Numax-cz/NapicuFridge/schematic/Fridge.sch

## EAGLE design schematic/Fridge.sch (2024-03-31)

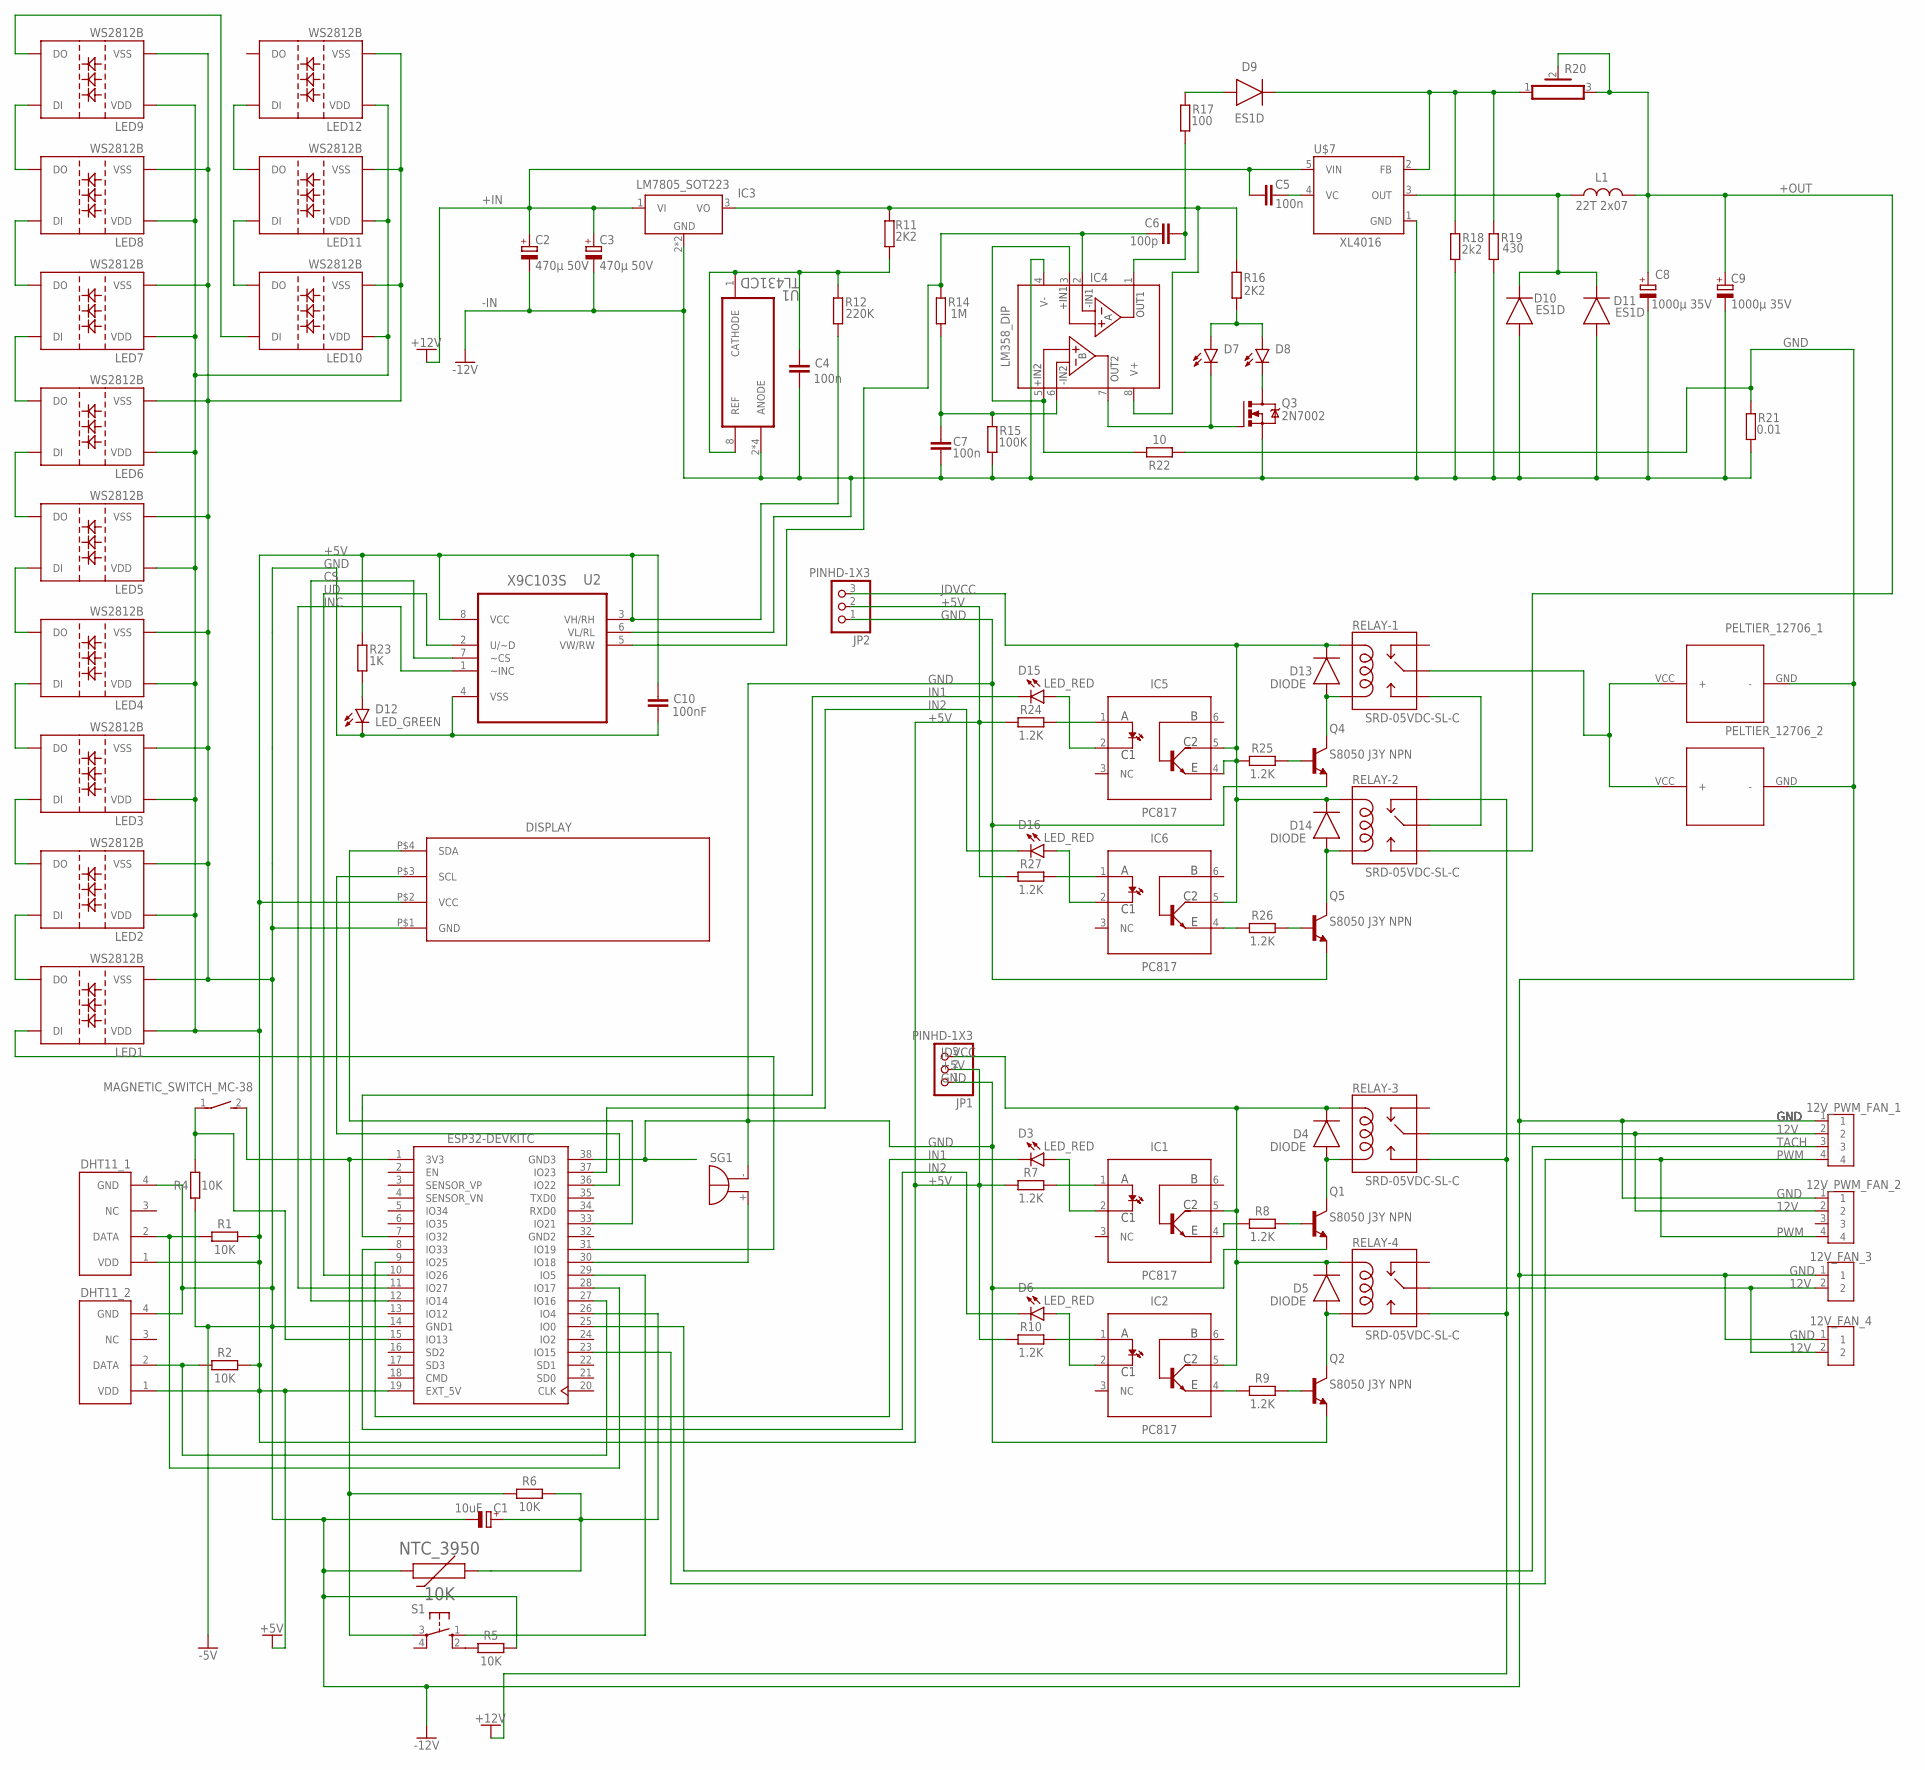
[picture p2: schematic Fridge.sch]

Parts:
12V_FAN_3, 12V_FAN_4: B2P-VH; B2P-VH_396-2N
12V_PWM_FAN_1: 12V_FAN1; B4B-XH-A
12V_PWM_FAN_2: B4B-XH-A
C1: 10uF; CAPPRD508W65D1000H1100B
C2, C3: 470µ 50V; CAPPRD550W60D1200H2000B
C4, C5, C7: 100n; CAPRD2261W240D5080H5555B
C6: 100p; CAPRD2261W240D5080H5555B
C8, C9: 1000µ 35V; CAPPRD550W60D1200H2000B
C10: 100nF; CAPC1005X60
D3, D6, D8, D15, D16: LED_RED; LEDC1005X25N_FLAT-R
D4, D5, D13, D14: DIODE; DIOMELF5024
D7: LED_BLUE; LEDC1005X25N_FLAT-R
D9, D10, D11: ES1D; DIOM5226X290N
D12: LED_GREEN; LEDC1005X25N_FLAT-R
DHT11_1: DHT11
IC1, IC2, IC5, IC6: PC817; DIP762W60P254L712H480Q6B
IC3: LM7805_SOT223; SOT230P700X170-4
IC4: LM358_DIP; DIP826W53P254L959H508Q8B
JP1, JP2: PINHD-1X3; 1X03
L1: 22T 2x07; INDRD2743W50D3810H2616B
LED1, LED2, LED3, LED4, LED5, LED6, LED7, LED8, LED9, LED10, LED11, LED12: WS2812B
MAGNETIC_SWITCH_MC-38: DS01E; DS-01
NTC_3950: 10K; THRMC1608X95
OLED: OLED; SIP
PELTIER_12706_1: PELTIER
PELTIER_12706_2: PELTIER_12706_2; PELTIER
Q1, Q2, Q4, Q5: S8050 J3Y NPN; SOT95P237X112-3N
Q3: 2N7002; SOT23
R1, R2, R4, R5, R6: 10K; RESAD724W46L381D178B
R7, R8, R9, R10, R24, R25, R26, R27: 1.2K; RESAD724W46L381D178B
R11, R16: 2K2; RESAD724W46L381D178B
R12: 220K; RESAD724W46L381D178B
R14: 1M; RESAD724W46L381D178B
R15: 100K; RESAD724W46L381D178B
R17: 100; RESAD724W46L381D178B
R18: 2k2; RESAD724W46L381D178B
R19: 430; RESAD724W46L381D178B
R20: PV36W
R21: 0.01; RESAD724W46L381D178B
R22: 10; RESAD724W46L381D178B
R23: 1K; RESAD724W46L381D178B
RELAY-1, RELAY-2, RELAY-3, RELAY-4: SRD-05VDC-SL-C
S1: 10-XX; B3F-10XX
SG1: EB2505
U1: TL431CD; SOIC127P599X175-8N
U2: X9C103S; SOIC127P600X175-8N
U3: ESP32-DEVKITC; MODULE_ESP32-DEVKITC
U$2: DHT11
U$7: XL4016; LM2576T2

Connections:
12V: 12V_FAN_3.2, 12V_FAN_4.2, 12V_PWM_FAN_1.2, 12V_PWM_FAN_2.2, RELAY-3.SWCOMMON, RELAY-4.SWCOMMON
+5V: C10.1, DHT11_1.1 (VDD), JP1.2, JP2.2, LED1.1 (VDD), LED2.1 (VDD), LED3.1 (VDD), LED4.1 (VDD), LED5.1 (VDD), LED6.1 (VDD), LED7.1 (VDD), LED8.1 (VDD), LED9.1 (VDD), LED10.1 (VDD), LED11.1 (VDD), LED12.1 (VDD), OLED.P$2 (VCC), R1.2, R2.2, R7.2, R10.2, R12.1, R23.2, R24.2, R27.2, U2.3 (VH/RH), U2.8 (VCC), U3.19 (EXT_5V), U$2.1 (VDD)
+12V: RELAY-2.SWCLOSED (SWCLOSE), RELAY-3.SWOPEN, RELAY-4.SWOPEN
+IN: C2.1 (+), C3.1 (+), C5.2, IC3.1 (VI), U$7.5 (VIN)
+OUT: C8.1 (+), C9.1 (+), L1.2, R20.2, R20.3, RELAY-2.SWOPEN
-IN: C2.2 (-), C3.2 (-), C4.2, C7.1, C8.2 (-), C9.2 (-), D10.2 (A), D11.2 (A), IC3.2 (GND), IC4.4 (V-), Q3.2 (S), R15.1, R18.1, R19.1, R21.1, U1.2 (ANODE), U2.6 (VL/RL), U$7.1 (GND)
CS: U2.7 (~CS), U3.12 (IO14)
GND: 12V_FAN_3.1, 12V_FAN_4.1, 12V_PWM_FAN_1.1, 12V_PWM_FAN_2.1, C1.2 (-), C10.2, D12.C, DHT11_1.4 (GND), JP1.1, JP2.1, LED1.3 (VSS), LED2.3 (VSS), LED3.3 (VSS), LED4.3 (VSS), LED5.3 (VSS), LED6.3 (VSS), LED7.3 (VSS), LED8.3 (VSS), LED9.3 (VSS), LED10.3 (VSS), LED11.3 (VSS), LED12.3 (VSS), NTC_3950.1, OLED.P$1 (GND), PELTIER_12706_1.GND (-), PELTIER_12706_2.GND (-), Q1.2 (E), Q2.2 (E), Q4.2 (E), Q5.2 (E), R4.2, R5.2, R21.2, R22.1, SG1.-, U2.4 (VSS), U3.14 (GND1), U3.38 (GND3), U$2.4 (GND)
IN1: D3.C, D15.C, U3.7 (IO32), U3.9 (IO25)
IN2: D6.C, D16.C, U3.8 (IO33), U3.37 (IO23)
INC: U2.1 (~INC), U3.11 (IO27)
JDVCC: D4.1 (C), D5.1 (C), D13.1 (C), D14.1 (C), IC1.5 (C2), IC2.5 (C2), IC5.4 (E), IC5.5 (C2), IC6.5 (C2), JP1.3, JP2.3, R25.1, RELAY-1.COIL1, RELAY-2.COIL1, RELAY-3.COIL1, RELAY-4.COIL1
unnamed: LED1.2 (DO), LED2.4 (DI)
unnamed: LED1.4 (DI), U3.31 (IO19)
unnamed: LED2.2 (DO), LED3.4 (DI)
unnamed: SG1.+, U3.30 (IO18)
unnamed: OLED.P$4 (SDA), U3.33 (IO21)
unnamed: DHT11_1.2 (DATA), R1.1, U3.28 (IO17)
unnamed: OLED.P$3 (SCL), U3.36 (IO22)
unnamed: IC5.1 (A), R24.1
unnamed: MAGNETIC_SWITCH_MC-38.2, R6.1, S1.3, U3.1 (3V3)
unnamed: S1.1 (S), U3.29 (IO5)
unnamed: R5.1, S1.2 (S1)
unnamed: D15.A, IC5.2 (C1)
unnamed: C1.1 (+), NTC_3950.2, R6.2, U3.26 (IO4)
unnamed: IC1.1 (A), R7.1
unnamed: D3.A, IC1.2 (C1)
unnamed: IC2.4 (E), R9.1
unnamed: IC1.4 (E), R8.1
unnamed: Q1.1 (B), R8.2
unnamed: D4.2 (A), Q1.3 (C), RELAY-3.COIL0
unnamed: Q2.1 (B), R9.2
unnamed: C4.1, R11.1, R12.2, U1.1 (CATHODE), U1.8 (REF)
unnamed: D5.2 (A), Q2.3 (C), RELAY-4.COIL0
unnamed: IC2.1 (A), R10.1
unnamed: D6.A, IC2.2 (C1)
unnamed: C5.1, U$7.4 (VC)
unnamed: C7.2, IC4.6 (-IN2), R14.1, R15.2
unnamed: LED9.2 (DO), LED10.4 (DI)
unnamed: C6.1, IC4.2 (-IN1), R14.2, U2.5 (VW/RW)
unnamed: IC4.3 (+IN1), IC4.5 (+IN2), R22.2
unnamed: C6.2, IC4.1 (OUT1), R17.1
unnamed: D7.A, D8.A, R16.1
unnamed: D8.C, Q3.3 (D)
unnamed: D7.C, IC4.7 (OUT2), Q3.1 (G)
unnamed: IC3.3 (VO), IC4.8 (V+), R11.2, R16.2
unnamed: D9.2 (A), R17.2
unnamed: D9.1 (C), R18.2, R19.2, R20.1, U$7.2 (FB)
unnamed: D10.1 (C), D11.1 (C), L1.1, U$7.3 (OUT)
unnamed: D12.A, R23.1
unnamed: Q4.1 (B), R25.2
unnamed: D13.2 (A), Q4.3 (C), RELAY-1.COIL0
unnamed: R2.1, U3.27 (IO16), U$2.2 (DATA)
unnamed: Q5.1 (B), R26.2
unnamed: D14.2 (A), Q5.3 (C), RELAY-2.COIL0
unnamed: IC6.1 (A), R27.1
unnamed: D16.A, IC6.2 (C1)
unnamed: IC6.4 (E), R26.1
unnamed: PELTIER_12706_1.VCC (+), PELTIER_12706_2.VCC (+), RELAY-1.SWCOMMON
unnamed: RELAY-1.SWOPEN, RELAY-2.SWCOMMON
unnamed: MAGNETIC_SWITCH_MC-38.1, R4.1, U3.15 (IO13)
unnamed: LED3.2 (DO), LED4.4 (DI)
unnamed: LED4.2 (DO), LED5.4 (DI)
unnamed: LED5.2 (DO), LED6.4 (DI)
unnamed: LED6.2 (DO), LED7.4 (DI)
unnamed: LED7.2 (DO), LED8.4 (DI)
unnamed: LED8.2 (DO), LED9.4 (DI)
unnamed: LED10.2 (DO), LED11.4 (DI)
unnamed: LED11.2 (DO), LED12.4 (DI)
PWM: 12V_PWM_FAN_1.4, 12V_PWM_FAN_2.4, U3.23 (IO15)
TACH: 12V_PWM_FAN_1.3, U3.25 (IO0)
UD: U2.2 (U/~D), U3.10 (IO26)
