Numax-cz/NapicuFridge/schematic/FridgeExtender.sch

## EAGLE design schematic/FridgeExtender.sch (2024-03-31)

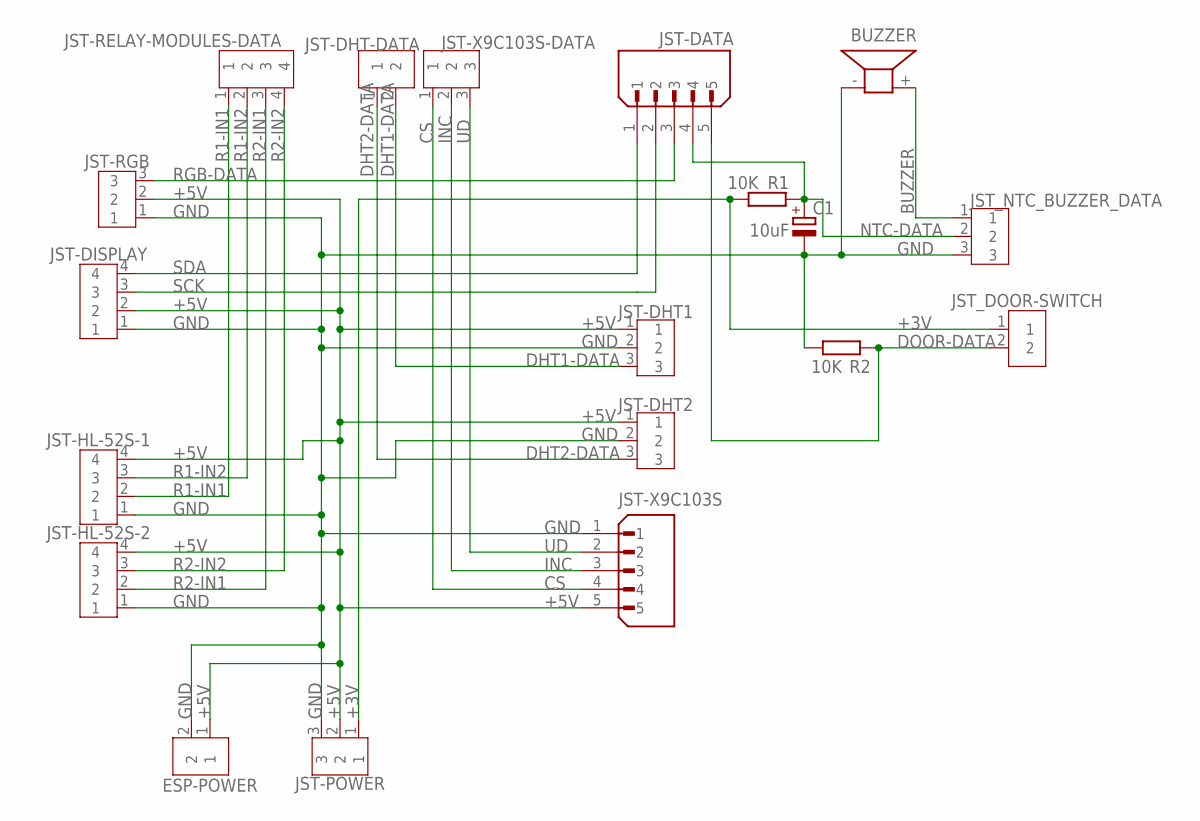
[picture p3: schematic FridgeExtender.sch]

Parts:
BUZZER: AL11P
C1: 10uF; CAPPRD508W65D1000H1100B
ESP-POWER: B2B-XH-A
JST-DATA: B5B-XH-A(LF)(SN); JST_B5B-XH-A(LF)(SN)
JST-DHT1, JST-DHT2: B3B-XH-A
JST-DHT-DATA: B2B-XH-A
JST-DISPLAY: B4B-XH-A
JST-HL-52S-1, JST-HL-52S-2: B4B-XH-A
JST-POWER: B3B-XH-A
JST-RELAY-MODULES-DATA: B4B-XH-A
JST-RGB: B3B-XH-A
JST-X9C103S: B5B-XH-A(LF)(SN); JST_B5B-XH-A(LF)(SN)
JST-X9C103S-DATA: B3B-XH-A
JST_DOOR-SWITCH: B2B-XH-A
JST_NTC_BUZZER_DATA: B3B-XH-A
R1, R2: 10K; RESAD724W46L381D178B

Connections:
+3V: JST-POWER.1, JST_DOOR-SWITCH.1, R1.1
+5V: ESP-POWER.1, JST-DHT1.1, JST-DHT2.1, JST-DISPLAY.2, JST-HL-52S-1.4, JST-HL-52S-2.4, JST-POWER.2, JST-RGB.2, JST-X9C103S.5
BUZZER: BUZZER.+ (2), JST_NTC_BUZZER_DATA.1
CS: JST-X9C103S.4, JST-X9C103S-DATA.1
DHT1-DATA: JST-DHT1.3, JST-DHT-DATA.2
DHT2-DATA: JST-DHT2.3, JST-DHT-DATA.1
DOOR-DATA: JST-DATA.5, JST_DOOR-SWITCH.2, R2.1
GND: BUZZER.- (1), C1.2 (-), ESP-POWER.2, JST-DHT1.2, JST-DHT2.2, JST-DISPLAY.1, JST-HL-52S-1.1, JST-HL-52S-2.1, JST-POWER.3, JST-RGB.1, JST-X9C103S.1, JST_NTC_BUZZER_DATA.3, R2.2
INC: JST-X9C103S.3, JST-X9C103S-DATA.2
NTC-DATA: C1.1 (+), JST-DATA.4, JST_NTC_BUZZER_DATA.2, R1.2
R1-IN1: JST-HL-52S-1.2, JST-RELAY-MODULES-DATA.1
R1-IN2: JST-HL-52S-1.3, JST-RELAY-MODULES-DATA.2
R2-IN1: JST-HL-52S-2.2, JST-RELAY-MODULES-DATA.3
R2-IN2: JST-HL-52S-2.3, JST-RELAY-MODULES-DATA.4
RGB-DATA: JST-DATA.3, JST-RGB.3
SCK: JST-DATA.2, JST-DISPLAY.3
SDA: JST-DATA.1, JST-DISPLAY.4
UD: JST-X9C103S.2, JST-X9C103S-DATA.3
