Numax-cz/NapicuFridge/schematic/FridgeFanExtender.sch

## EAGLE design schematic/FridgeFanExtender.sch (2024-03-31)

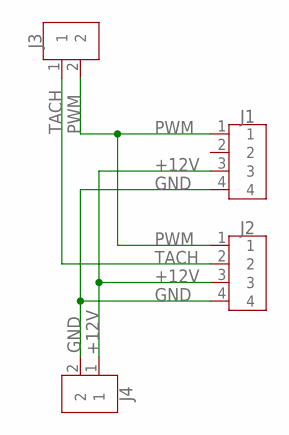
[picture p4: schematic FridgeFanExtender.sch]

Parts:
J1, J2: B4B-XH-A
J3, J4: B2B-XH-A

Connections:
+12V: J1.3, J2.3, J4.1
GND: J1.4, J2.4, J4.2
PWM: J1.1, J2.1, J3.2
TACH: J2.2, J3.1
