Numax-cz/NapicuFridge/(commit log)

2023-06-01 Přidány scripty, upraveny BT bugy
    [main.cpp]
2023-06-12 Upraveny bugy, updata balíčků
    [CallBack.cpp, main.cpp, main.h]
2023-07-05 Přidán whitelist, opraveny bugy
    [CallBack.cpp, main.cpp, main.h]
2023-07-06 Přidány základní struktura pro nastavení ledničky
2023-07-06 Přidána základní funkce pro tovární resetování
    [main.cpp, main.h]
2023-07-07 Upraveny partition
    [partition.csv]
2023-08-01 Opraveny bugy, přidána dokumentace
    [fridgeDisplay.cpp, fridgeTempDHT.cpp, main.cpp, main.h]
2023-09-03 Přidána základní struktura pro reset button
2023-09-06 Implementován thermistor
2023-09-08 Upraven pin
2023-09-30 Přidána správa PWM ventilátorů
2023-09-30 Opraveny bugy relátek a řídiče PWM ventilátorů
    [main.cpp, relayModule.cpp]
2023-10-07 Opraveny bugy, upraveny piny, upraveno UI
    [main.h, powerManager.cpp]
2023-10-08 Upraveno UI, přidána možnost řízení výkonu ledničky
2023-10-09 Přejmenovány proměnné, upraveno UI, přidána zpráva o chybách ledničky
2023-10-14 Přidán manager pro piezo a pro errory
    [errorChecker.cpp, main.cpp, main.h, piezoManager.cpp]
2023-10-14 Opraveny bugy, přidány nové funkce, upravena dokumentace
    [errorChecker.cpp, main.cpp, main.h, piezoManager.cpp]
2023-10-14 Upravena správa errorů, opraveny bugy, přidáno bzučení při errorů, upraveno UI + styly
    [errorChecker.cpp, main.cpp, main.h]
2023-10-15 Přidána třída pro thermistor, upravena dokumentace
2023-10-22 Implementována možnost okamžitého získání naměřených hodnot skrze JSON formát, opraveny bugy
    [dataJSONManager.cpp, main.cpp, main.h]
2023-10-29 Upravena funkce pro uvedení ledničky do továrního nastavení
2023-10-31 Přidána charakteristika pro uvedení ledničky do továrního nastavení
2023-10-31 Upraveny proměnné, implementována funkce pro uvedení ledničky do továrního nastavení
2023-11-06 Přidána funkce pro pozastavení ledničky při otevření dveří
2023-11-26 Přidáno pozastavení ledničky při otevřených dveří, opraveny chyby
2023-12-04 Přidána změna barev všech ledek ve světle
2023-12-04 Přidán styl nastavení jasu LED světla
2023-12-09 Upraveny styly, přidán design pro oblíbené barvy, přidána možnost vypnout led
2024-01-04 Opraveny bugy, přidána možnost vymazat graf při vypnutí ledničky
    [dataJSONManager.cpp, main.h, powerManager.cpp]
2024-02-11 Opraveny bugy, přidána kontrola ventilátorů
    [errorChecker.cpp, main.cpp, powerManager.cpp]
2024-03-31 Přidána možnost zapojení ventilátorů bez PWM
2024-03-31 Přidána dokumentace
    [DokumentacePristroje.xlsx, DokumentaceSoucastky.xlsx, Fridge.sch, FridgeExtender.sch, FridgeFanExtender.sch]
